CameronBrooks11/din168-thread-scad/examples/gl45_cap.scad

// A GL45 screw cap, ribbed, and a short GL45 gauge to try it on without a bottle.
use <../din168.scad>

gl = din168_by_name("GL45");

// Shown as printed: top on the bed, mouth up. din168_cap draws it mouth down, its top from z = 0
// to z = top.
top = 3;
translate([0, 0, top]) rotate([180, 0, 0]) din168_cap(gl, top=top, ribs=36);
translate([70, 0, 0]) din168_bolt(gl, length=12, bore=30);
