CameronBrooks11/din168-thread-scad/(list of files, cad)

Other CAD files:
examples/gl80_cap.scad
