CameronBrooks11/din168-thread-scad/(commit log)

2026-09-24 feat: add a GL size table, a helical thread and a screw cap
    din168.scad carries GL25, GL28, GL32 and GL45 from two published
    tables, recorded with their URLs in docs/references.md. The thread is
    one polyhedron swept along a true helix, trimmed to length, with the
    glass at 60 degree flanks and the cap at 30. The cap clears the largest
    in-tolerance glass by a stated clearance, and a cap module closes the
    nut with a top.
    [din168.scad, gl45_cap.scad]
2026-09-24 refactor: remove the slice-stacked thread and the unthreaded cap blanks
    din168.scad replaces gl_threads.scad, whose helix of stacked slices
    did not finish in 15 minutes on OpenSCAD 2021.01, and its cap module
    replaces the blanks in deckel.scad.
    [deckel.scad, gl_threads.scad]
2026-09-27 feat: build the library from DIN 168-1 (#1)
    Rebuild the library from DIN 168-1:1998-04 (Tabelle 1 and Bild 1)
    instead of the two web tables it started from.
    - Every size, GL8 to GL125, 24 rows including GL25 x 3.5, selected
    with din168_by_name("GL25", pitch=3.5). The standard corrects three
    web-table cells: GL56 bolt core min, GL100 bolt outer min and GL112
    bolt core min.
    - Cut the thread to Bild 1: the glass tooth P*k wide at its core, crests
    rounded to R1 and roots to R2, 60 deg flanks on the glass and 30 in
    the cap. Clearance shrinks each tooth on every face.
    - Fix the cap's groove root and the gauge's crests, which faceted
    cylinders at the caller's $fa cut into: 0.13 mm on G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
    [all_sizes.scad, din168.scad, gl45_cap.scad, gl80_cap.scad]
2026-09-29 feat(cap): add an optional skirt below the thread (#2)
    Printed caps fit but look short next to shop-bought ones. No standard
    sets a cap's height: DIN 168-1 gives only the thread, and ISO 4796-1
    leaves the bottle's neck to the maker. Shop-bought caps also carry a
    skirt, plain wall below the thread that covers the neck. This adds one
    as an option.
    - `din168_cap(skirt)`: `false` (default) for none, `true` for one pitch
    (4 mm on GL45, 5 mm on GL80), or a length in mm. The one-pitch default
    is marked `CHOICE`. Its bore is the thread's root, so the glass's whole
    thread passes through.
    - `din168_cap_height(size, …, skirt)`: a cap's overall height. The
    examples use it in place of `12 + 2 + 3`.
    -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
    [all_sizes.scad, din168.scad, gl45_cap.scad, gl80_cap.scad]
2026-09-30 feat(cap)!: put a cap's z = 0 at the seal plane (#3)
    `din168_cap` drew z = 0 at the mouth, so placing a cap on a bottle meant
    adding up its thread length, liner space and skirt. Adding a skirt then
    moved every cap placed that way. The physical interface is the rim, so z
    = 0 is now the seal plane, where the glass's rim meets the inside of the
    top.
    | Use | Before | After |
    | --- | --- | --- |
    | Cap on a bottle | `translate(rim − skirt − thread − liner)` |
    `translate([0, 0, rim])` |
    | Printed, flipped | `translate(din168_cap_height(...))` |
    `translate([0, 0, top]) rotate([180, 0, 0])` |
    | Something on the top | `z = skirt + thread + liner + top` | `z = top`
    |
    **Breaking.** A caller that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
    [all_sizes.scad, din168.scad, gl45_cap.scad, gl80_cap.scad]
2026-10-04 chore: ignore build output, editor files and CAD exports
2026-10-05 feat(cap)!: thread caps five pitches deep, add GLS 80 and ring band (#4)
    Three changes to the cap, from DURAN's published figures and one
    measured third-party cap. Sources and measurements are in
    `docs/references.md`.
    **Thread depth.** A cap's thread defaults to five pitches
    (`din168_default_thread_length`) and runs from 2 mm under the top to the
    mouth. The GL45 cap goes from 17 mm to 25 mm, the height of DURAN's PP
    GL45 cap (cat. 29 239 28 09, 54 × 25 mm). DURAN's GL caps are 17 to 28
    mm tall, which is 5.25 to 6.67 pitches inside a 3 mm top. No standard
    gives a cap's thread length.
    **GLS 80.** `din168_by_name("GLS80")` returns GL80's profile and
    diameters with three starts and a 15 mm le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
    [din168.scad, gls80_cap.scad]
2026-10-30 docs: record the GL45 and GLS 80 test prints (#6)
    Adds a Test prints section to `docs/references.md`: caps printed from
    7ea65c3 and tried on DURAN bottles on 2026-10-05.
    - GL45, 25 mm with 20 mm of thread: threads on cleanly and seats fully,
    more cleanly than the 12 mm thread it replaced.
    - GLS 80, 30 mm with 25 mm of three-start thread: fits. Without a gasket
    it is not watertight, so it needs a seal in the liner space.
    - The DIN GL80 cap printed before GLS 80 existed caught a GLS 80 neck
    for a fraction of a turn and came off.
